dj140/STM32F103_FOC/STM32_FOC.kicad_pcb

## KiCad design STM32_FOC.kicad_pcb (2021-10-30)

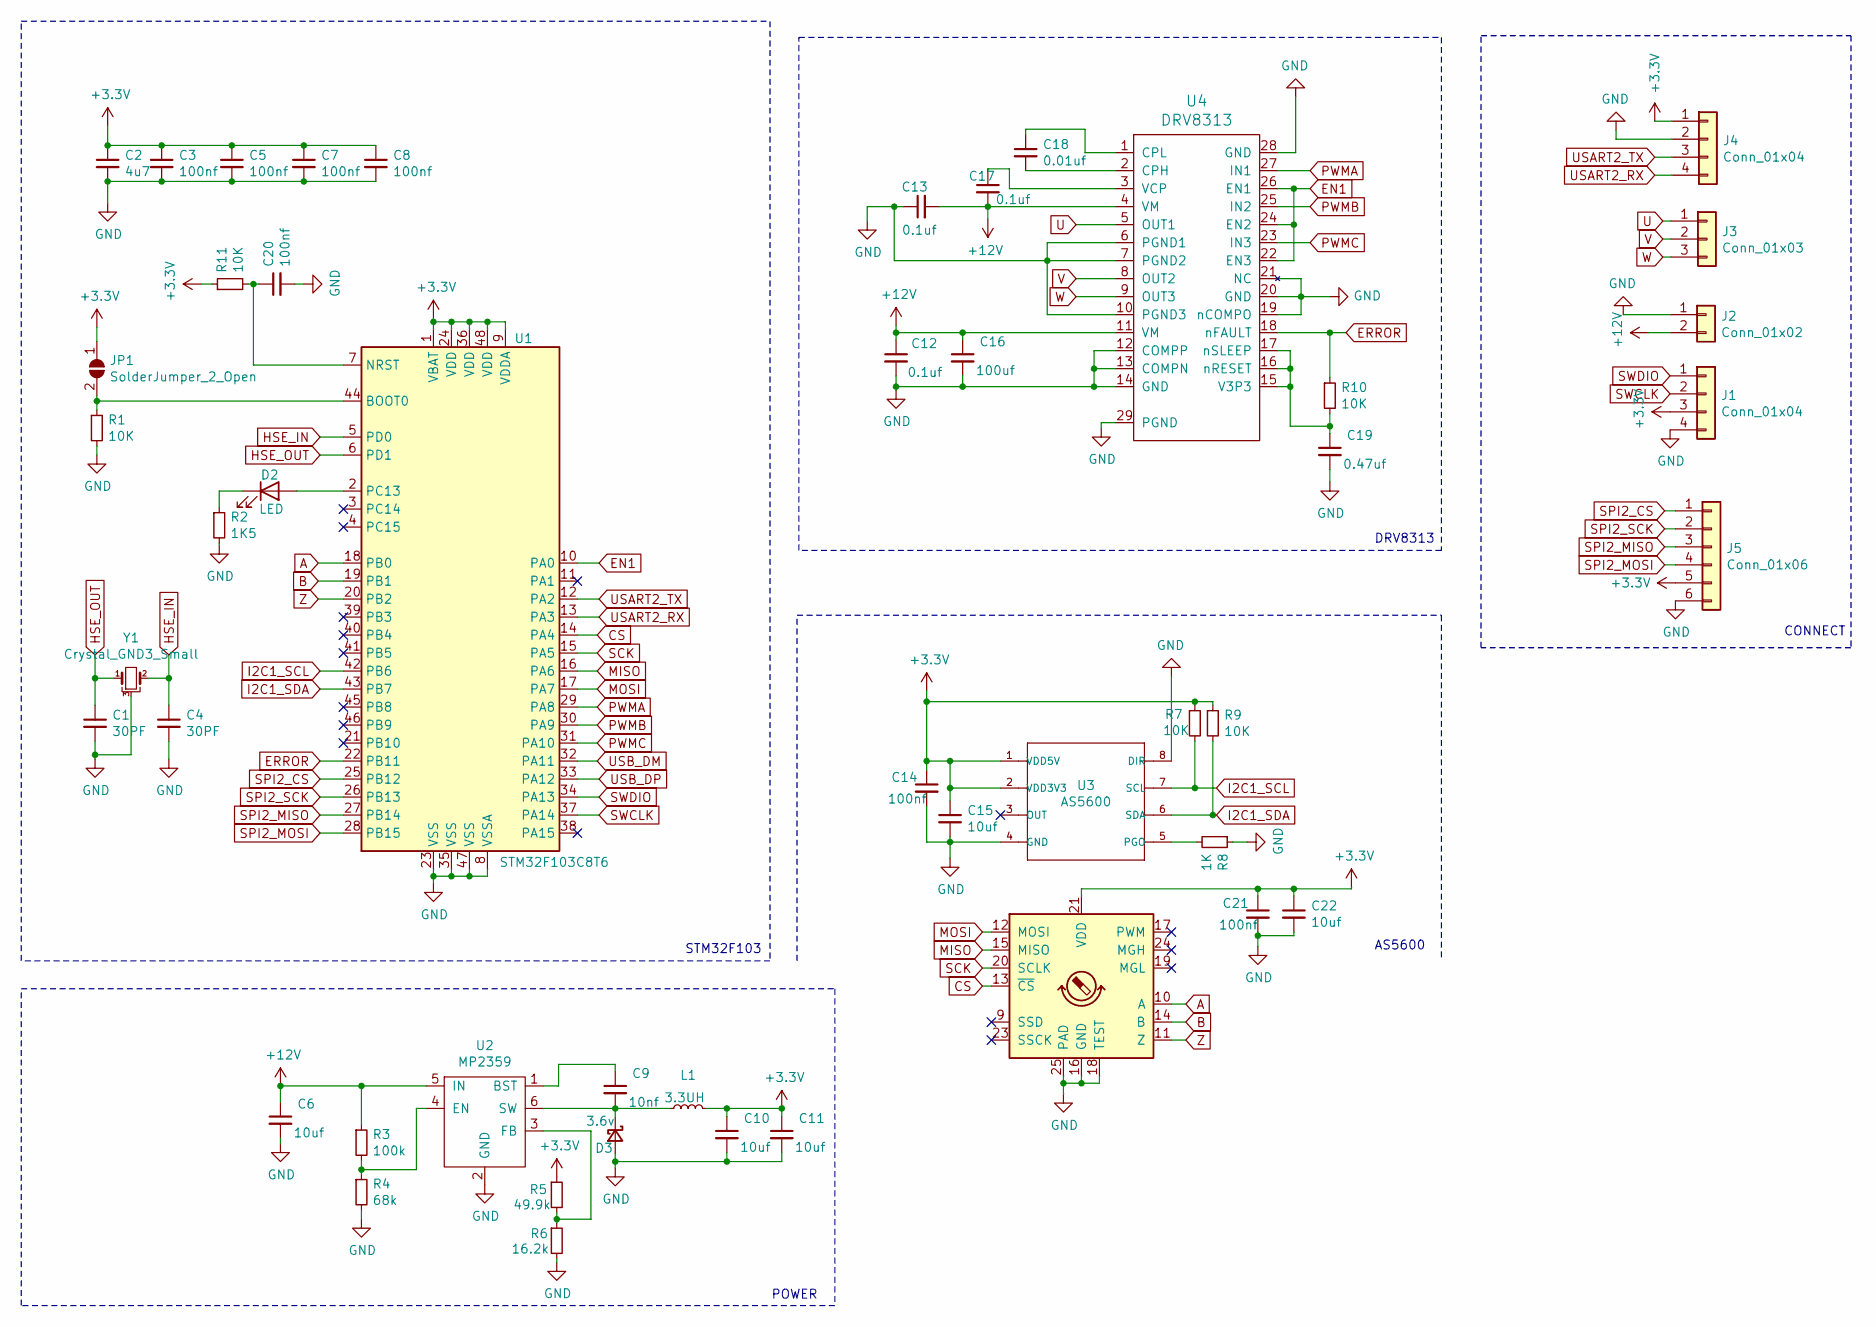
[picture p1: schematic STM32_FOC.sch]

Parts:
C1, C4: 30PF; C_0402_1005Metric
C2: 4u7; C_0402_1005Metric
C3, C5, C7, C8, C14, C20, C21: 100nf; C_0402_1005Metric
C6, C15, C22: 10uf; C_0603_1608Metric
C9: 10nf; C_0402_1005Metric
C10, C11: 10uf; C_0402_1005Metric
C12: 0.1uf; C_0603_1608Metric
C13, C17: 0.1uf; C_0402_1005Metric
C16: 100uf; C_1206_3216Metric
C18: 0.01uf; C_0402_1005Metric
C19: 0.47uf; C_0402_1005Metric
D2: LED; LED_0402_1005Metric
D3: 3.6v; D_SOD-123
J1, J4: Conn_01x04; JST_SH_SM04B-SRSS-TB_1x04-1MP_P1.00mm_Horizontal
J2: Conn_01x02; JST_SH_SM02B-SRSS-TB_1x02-1MP_P1.00mm_Horizontal
J3: Conn_01x03; PinHeader_1x03_P2.54mm_Vertical
J5: Conn_01x06; JST_SH_SM06B-SRSS-TB_1x06-1MP_P1.00mm_Horizontal
JP1: SolderJumper_2_Open; SoldJumper-2-P0.5mm_Open_RoundedPad
L1: 3.3UH; L_0420
R1, R7, R9, R10, R11: 10K; R_0402_1005Metric
R2: 1K5; R_0402_1005Metric
R3: 100k; R_0402_1005Metric
R4: 68k; R_0402_1005Metric
R5: 49.9k; R_0402_1005Metric
R6: 16.2k; R_0402_1005Metric
R8: 1K; R_0402_1005Metric
U1: STM32F103C8T6; LQFP-48_7x7mm_P0.5mm
U2: MP2359; SOT-23-6
U3: AS5600
U4: DRV8313; SquantorTexasInstruments-HTSSOP-28
Y1: Crystal_GND3_Small; CSTCE8M00G55-R0

Connections:
+3V3: C2.1, C3.1, C5.1, C7.1, C8.1, C10.1, C11.1, C14.1, C15.1, C21.1, C22.1, J1.3, J4.1, J5.5, JP1.1 (A), L1.2, R5.1, R7.1, R9.1, R11.1, U1.1 (VBAT), U1.9 (VDDA), U1.24 (VDD), U1.36 (VDD), U1.48 (VDD), U3.1 (VDD5V), U3.2 (VDD3V3), U3.21 (VDD)
+12V: C6.1, C12.1, C13.2, C16.1, C17.2, J2.2, R3.1, U2.5 (IN), U4.4 (VM), U4.11 (VM)
A: U1.18 (PB0), U3.10 (A)
B: U1.19 (PB1), U3.14 (B)
CS: U1.14 (PA4), U3.13 (~CS)
EN1: U1.10 (PA0), U4.22 (EN3), U4.24 (EN2), U4.26 (EN1)
ERROR: R10.1, U1.22 (PB11), U4.18 (nFAULT)
GND: C1.2, C2.2, C3.2, C4.2, C5.2, C6.2, C7.2, C8.2, C10.2, C11.2, C12.2, C13.1, C14.2, C15.2, C16.2, C19.2, C20.2, C21.2, C22.2, D3.2 (A), J1.4, J2.1, J4.2, J5.6, R1.2, R2.2, R4.2, R6.2, R8.1, U1.8 (VSSA), U1.23 (VSS), U1.35 (VSS), U1.47 (VSS), U2.2 (GND), U3.4 (GND), U3.8 (DIR), U3.16 (GND), U3.18 (TEST), U3.25 (PAD), U4.6 (PGND1), U4.7 (PGND2), U4.10 (PGND3), U4.12 (COMPP), U4.13 (COMPN), U4.14 (GND), U4.19 (nCOMPO), U4.20 (GND), U4.21 (NC), U4.28 (GND), U4.29 (PGND), Y1.3
HSE_IN: C4.1, U1.5 (PD0), Y1.2
HSE_OUT: C1.1, U1.6 (PD1), Y1.1
I2C1_SCL: R7.2, U1.42 (PB6), U3.7 (SCL)
I2C1_SDA: R9.2, U1.43 (PB7), U3.6 (SDA)
MISO: U1.16 (PA6), U3.15 (MISO)
MOSI: U1.17 (PA7), U3.12 (MOSI)
unnamed: C9.1, U2.1 (BST)
unnamed: C9.2, D3.1 (K), L1.1, U2.6 (SW)
unnamed: C17.1, U4.3 (VCP)
unnamed: C18.1, U4.1 (CPL)
unnamed: C18.2, U4.2 (CPH)
unnamed: C19.1, R10.2, U4.15 (V3P3), U4.16 (nRESET), U4.17 (nSLEEP)
unnamed: C20.1, R11.2, U1.7 (NRST)
unnamed: D2.1 (K), R2.1
unnamed: D2.2 (A), U1.2 (PC13)
unnamed: JP1.2 (B), R1.1, U1.44 (BOOT0)
unnamed: R3.2, R4.1, U2.4 (EN)
unnamed: R5.2, R6.1, U2.3 (FB)
unnamed: R8.2, U3.5 (PGO)
PWMA: U1.29 (PA8), U4.27 (IN1)
PWMB: U1.30 (PA9), U4.25 (IN2)
PWMC: U1.31 (PA10), U4.23 (IN3)
SCK: U1.15 (PA5), U3.20 (SCLK)
SPI2_CS: J5.1, U1.25 (PB12)
SPI2_MISO: J5.3, U1.27 (PB14)
SPI2_MOSI: J5.4, U1.28 (PB15)
SPI2_SCK: J5.2, U1.26 (PB13)
SWCLK: J1.2, U1.37 (PA14)
SWDIO: J1.1, U1.34 (PA13)
U: J3.1, U4.5 (OUT1)
USART2_RX: J4.4, U1.13 (PA3)
USART2_TX: J4.3, U1.12 (PA2)
USB_DM: U1.32 (PA11)
USB_DP: U1.33 (PA12)
V: J3.2, U4.8 (OUT2)
W: J3.3, U4.9 (OUT3)
Z: U1.20 (PB2), U3.11 (Z)

Notes on the sheet:
STM32F103
AS5600
DRV8313
POWER
CONNECT

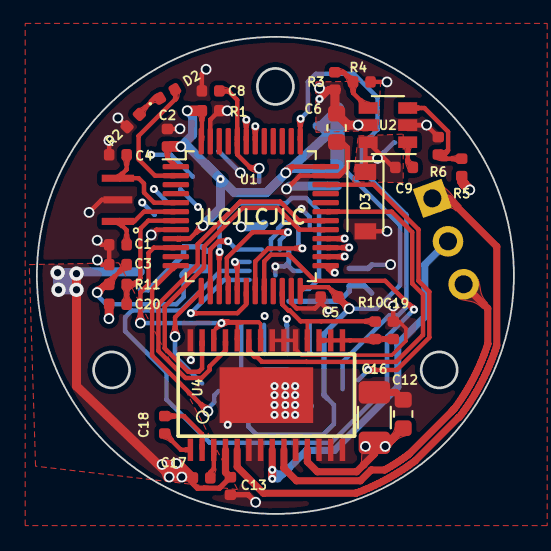
[picture p2: board STM32_FOC.kicad_pcb from above]

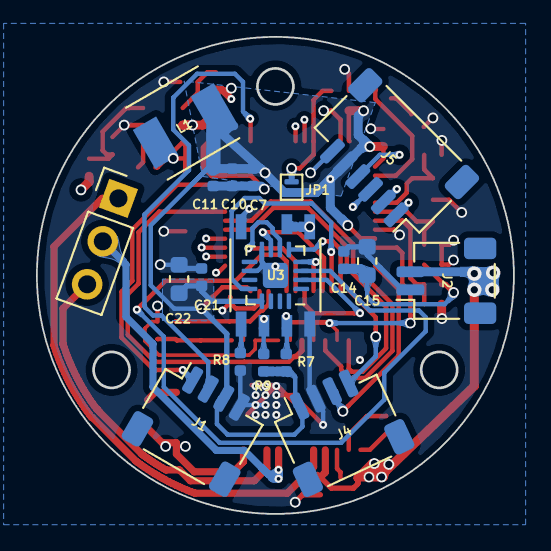
[picture p3: board STM32_FOC.kicad_pcb from below]

Board: 4 copper layers, 26.5 x 26.5 mm, 47 parts (18 on the bottom side), 43 nets.
